R-Mutura/DISHWASHER/dish_washwer_hardware/png/Steel_form_Dish_washer 5.png

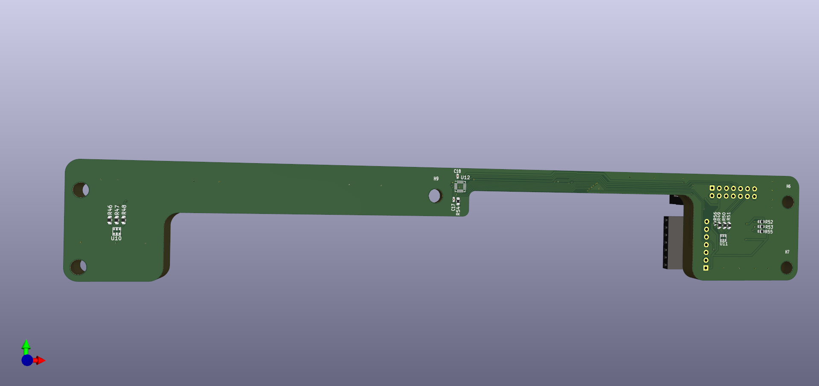
dish_washwer_hardware/png/Steel_form_Dish_washer 5.png
