R-Mutura/DISHWASHER/dish_washwer_hardware/png/Steel_form_Dish_washer 6.png

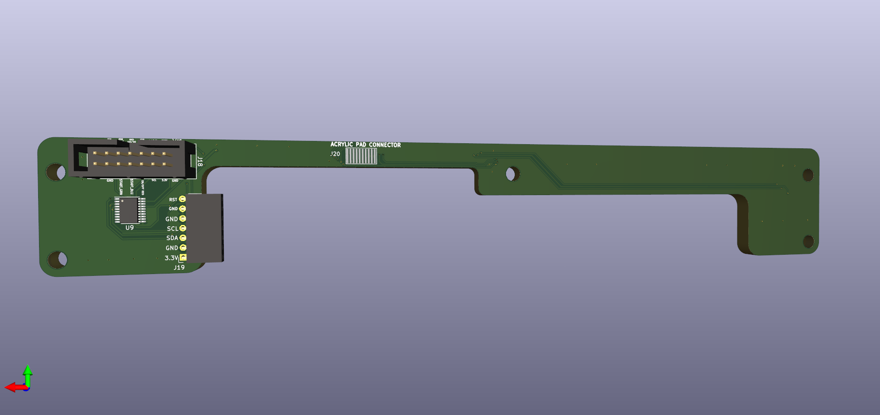
dish_washwer_hardware/png/Steel_form_Dish_washer 6.png
