R-Mutura/DISHWASHER/dish_washwer_hardware/png/main pcb 1.png

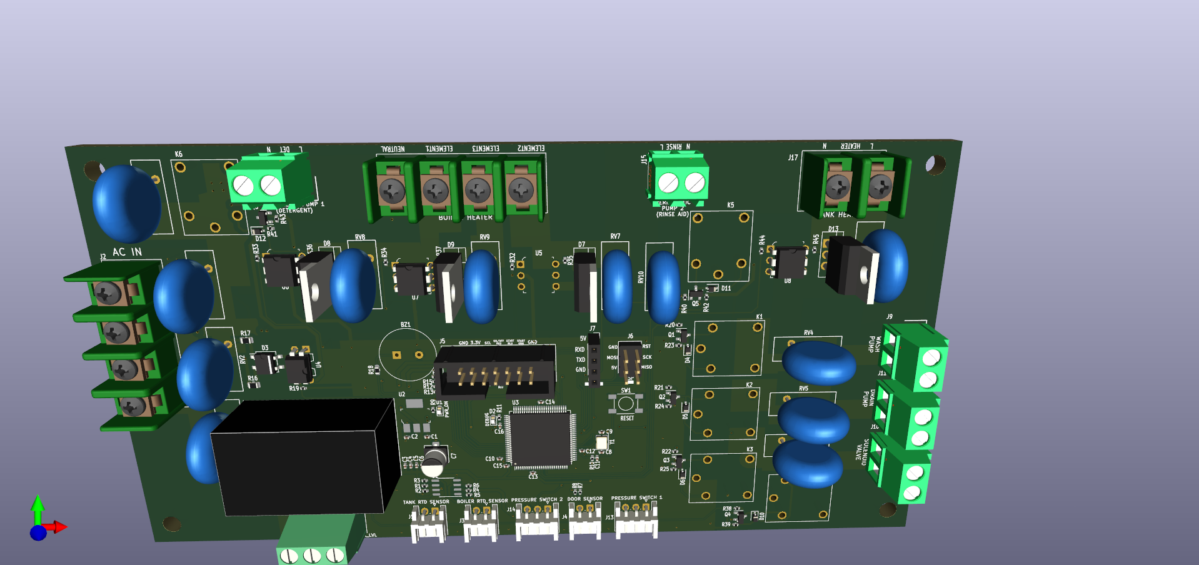
dish_washwer_hardware/png/main pcb 1.png
