R-Mutura/DISHWASHER/dish_washwer_hardware/png/main pcb 2.png

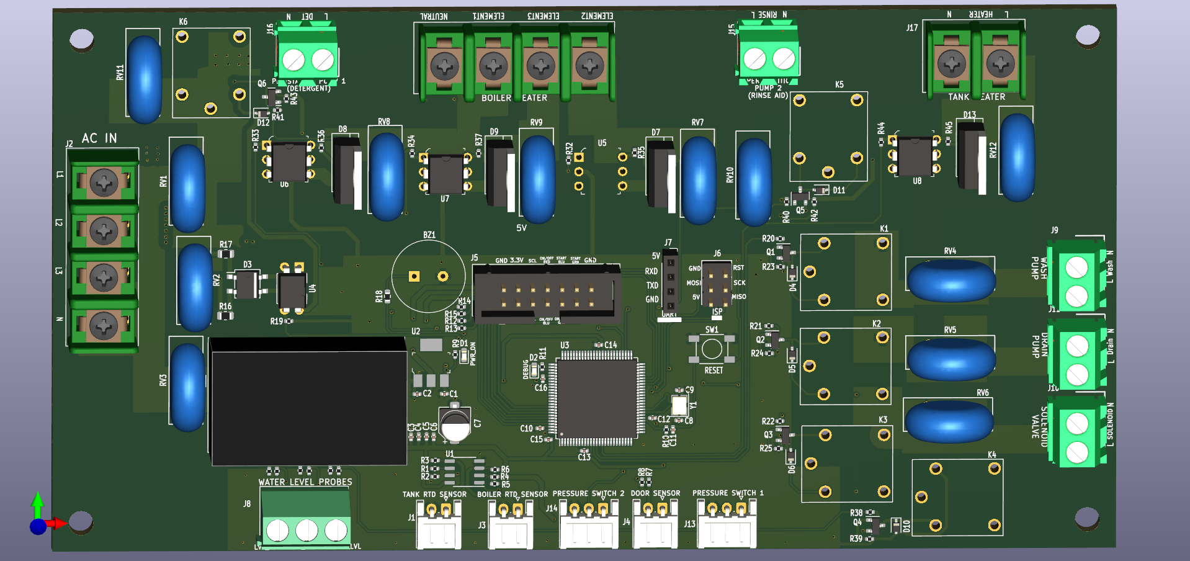
dish_washwer_hardware/png/main pcb 2.png
