R-Mutura/DISHWASHER/dish_washwer_hardware/png/main pcb 3.png

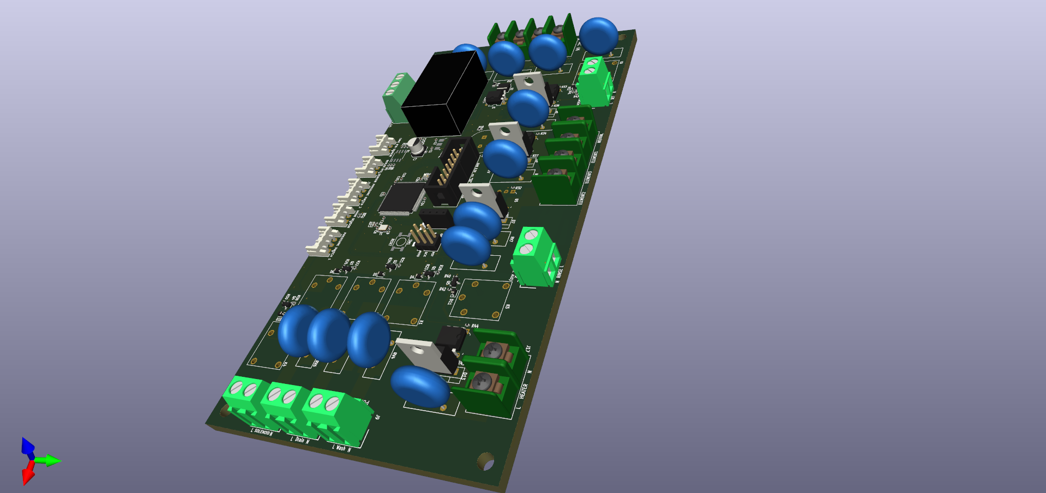
dish_washwer_hardware/png/main pcb 3.png
