R-Mutura/DISHWASHER/dish_washwer_hardware/png/Steel_form_Dish_washer 7.png

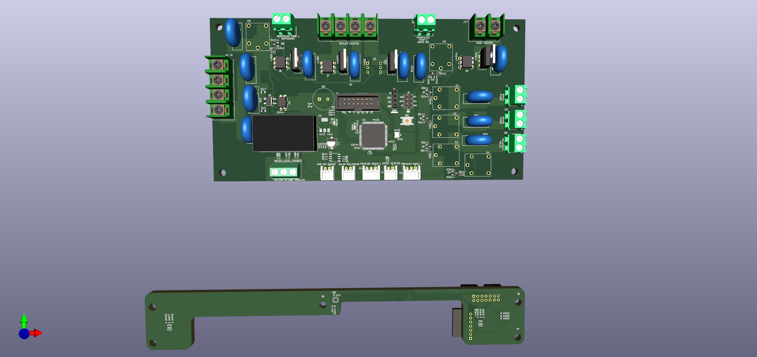
dish_washwer_hardware/png/Steel_form_Dish_washer 7.png
