R-Mutura/DISHWASHER/dish_washwer_hardware/BOM/AUXILLARY PCB BOM V2.xlsx

Reference | Value | Footprint | MPN | Vendor | QTY
C17, C18 | 100nF | Capacitor_SMD:C_0402_1005Metric | CC0402KRX5R9BB104 | LCSC | 2
J18 | Conn_02x07_Odd_Even | Connector_IDC:IDC-Header_2x07_P2.54mm_Vertical | Z-231011814106 | LCSC | 1
J19 | SCREEN CONNECTOR | Connector_PinSocket_2.54mm:PinSocket_1x07_P2.54mm_Horizontal | A2541HWR-7P | LCSC | 1
R46, R48, R49, R51 | 100R | Resistor_SMD:R_0603_1608Metric | RC0603FR-07100RL | LCSC | 4
R47, R50 | 150R | Resistor_SMD:R_0603_1608Metric | 0603WAJ0151T5E | LCSC | 2
R52, R53, R55 | 4.7K | Resistor_SMD:R_0603_1608Metric | RC0603JR-074K7L | LCSC | 3
R54 | 75K | Resistor_SMD:R_0603_1608Metric | 0603WAF7502T5E | LCSC | 1
R56 | 4.7K | Resistor_SMD:R_0402_1005Metric | RC0402FR-074K7L | LCSC | 1
U9 | TXS0108EPW | Package_SO:TSSOP-20_4.4x6.5mm_P0.65mm | TXS0108EPW | LCSC | 1
> U10, U11 | EAST1616RGBA8 | greencharge-footprints:EAST1616RGBA8 | EAST1616RGBA8 | Digikey | 2
U12 | MPR121QR2 | Package_DFN_QFN:UQFN-20_3x3mm_P0.4mm | MPR121QR2 | Digipart | 1
