R-Mutura/DISHWASHER/dish_washwer_hardware/BOM/MAIN PCB BOM V2.xlsx

Reference | Value | Footprint | MPN | Vendor | QTY
BZ1 | PS1240P02BT | digikey-footprints:Piezo_Transducer_THT_PS1240P02BT | PS1240P02BT | LCSC | 1
C1 | 10uF | Capacitor_SMD:C_0402_1005Metric | CC0402MRX5R5BB106 | LCSC | 1
C2 | 1uF | Capacitor_SMD:C_0402_1005Metric | CC0402KRX5R6BB105 | LCSC | 1
C7 | 100u | Capacitor_SMD:CP_Elec_5x5.4 | RVT100UF10V67RV0036 | LCSC | 1
C8, C9 | 22pF | Capacitor_SMD:C_0402_1005Metric | CC0402JRNPO9BN220 | LCSC | 2
C3-C6, C10, C12-C16 | 100nF | Capacitor_SMD:C_0402_1005Metric | CC0402KRX5R9BB104 | LCSC | 10
C11 | 4.7nF | Capacitor_SMD:C_0402_1005Metric | CC0402KRX7R9BB472 | LCSC | 1
D1 | LED_Small | LED_SMD:LED_0603_1608Metric | SZYY0603R | LCSC | 1
D2 | LED_Small | LED_SMD:LED_0603_1608Metric | SZYY0603B | LCSC | 1
D3 | MB6S | Package_TO_SOT_SMD:TO-269AA | MB6S | LCSC | 1
D4-D6, D10-D12 | B5819WS | Diode_SMD:D_SOD-323 | B5819WS | LCSC | 6
D7-D9, D13 | Q_TRIAC_A1A2G | Package_TO_SOT_THT:TO-220-3_Vertical | MAC223A6,126 | Digikey | 4
J1 | RTD_BOILER_SENSOR | Connector_JST:JST_EH_S2B-EH_1x02_P2.50mm_Horizontal | S2B-XH-A(LF)(SN) | LCSC | 1
J2 | AC_PWR_IN | greencharge-footprints:KF8500-4PIN | KF8500-4PIN | https://de.aliexpress.com/item/32701344105.html?gatewayAdapt=glo2deu | 1
J3 | RTD_TANK_SENSOR | Connector_JST:JST_EH_S2B-EH_1x02_P2.50mm_Horizontal | S2B-XH-A(LF)(SN) | LCSC | 1
J4 | MAG_DOOR_SENSOR | Connector_JST:JST_EH_S2B-EH_1x02_P2.50mm_Horizontal | S2B-XH-A(LF)(SN) | LCSC | 1
J5 | Conn_02x07_Odd_Even | Connector_IDC:IDC-Header_2x07_P2.54mm_Vertical | Z-231011814106 | LCSC | 1
J6 | Conn_02x03_Odd_Even | Connector_PinHeader_2.54mm:PinHeader_2x03_P2.54mm_Vertical | 210-72-03GB01 | LCSC | 1
J7 | Conn_01x04_Male | Connector_PinSocket_2.54mm:PinSocket_1x04_P2.54mm_Vertical | 210-91-04GB01 | LCSC | 1
J8 | Conn_01x03_Male | TerminalBlock_Phoenix:TerminalBlock_Phoenix_MKDS-1,5-3-5.08_1x03_P5.08mm_Horizontal | WJ500V-5.08-3P | LCSC | 1
J9 | WASH PUMP CONNECTOR | greencharge-footprints:SHDR2W100P0X508_1X2_1070X900X1380P | DB128V-5.0-4P-GN-S | LCSC | 1
J10 | SOLENOID CONNECTOR | greencharge-footprints:SHDR2W100P0X508_1X2_1070X900X1380P | XY126V-5.0-2P | LCSC | 1
J11 | DRAIN PUMP CONNECTOR | greencharge-footprints:SHDR2W100P0X508_1X2_1070X900X1380P | XY126V-5.0-2P | LCSC | 1
J12 | BOILER HEATER CONNECTOR | greencharge-footprints:KF8500-4PIN | KF8500-4PIN | https://de.aliexpress.com/item/32701344105.html?gatewayAdapt=glo2deu | 1
J13 | Pressure Switch 1 | Connector_JST:JST_EH_S3B-EH_1x03_P2.50mm_Horizontal | S3B-XH-A(LF)(SN) | LCSC | 1
J14 | Pressure Switch 2 | Connector_JST:JST_EH_S3B-EH_1x03_P2.50mm_Horizontal | S3B-XH-A(LF)(SN) | LCSC | 1
J15 | peristaltic_pump_1 | greencharge-footprints:SHDR2W100P0X508_1X2_1070X900X1380P | XY126V-5.0-2P | LCSC | 1
J16 | peristaltic_pump_2 | greencharge-footprints:SHDR2W100P0X508_1X2_1070X900X1380P | XY126V-5.0-2P | LCSC | 1
J17 | TANK HEATER | greencharge-footprints:KF8500-2PIN | KF8500-2PIN | https://de.aliexpress.com/item/32701344105.html?gatewayAdapt=glo2deu | 1
K1-K6 | SRA-05VDC-CL | greencharge-footprints:SRA-05VDC-CL | SRA-05VDC-CL | LCSC | 6
PS1 | HLK-PM01 | Converter_ACDC:Converter_ACDC_HiLink_HLK-PMxx | HLK-PM01 | LCSC | 1
Q1-Q3, Q5, Q6 | mmbt3904 | Package_TO_SOT_SMD:SOT-23 | mmbt3904 | LCSC | 5
Q4 | AP2301 | Package_TO_SOT_SMD:SOT-23 | AP2301 | LCSC | 1
R2, R5, R19, R26-R28, R38 | 1K | Resistor_SMD:R_0402_1005Metric | RC0402FR-071KL | LCSC | 7
R7, R32-R34, R44 | 200R | Resistor_SMD:R_0402_1005Metric | RC0402FR-07200RL | LCSC | 5
R9, R11 | 500R | Resistor_SMD:R_0402_1005Metric | RC0402FR-07523RL | LCSC | 2
R1, R3, R4, R6, R8, R10, R23-R25, R35-R37, R39, R42, R43, R45 | 10K | Resistor_SMD:R_0402_1005Metric | AC0402FR-0710KL | LCSC | 16
R12-R15 | 4.7k | Resistor_SMD:R_0402_1005Metric | RC0402FR-074K7L | LCSC | 4
R16, R17 | 47K | Resistor_SMD:R_0805_2012Metric | RC0402FR-0747KL | LCSC | 2
R18 | 100R | Resistor_SMD:R_0603_1608Metric | RC0402FR-07100RL | LCSC | 1
R20-R22, R40, R41 | (680R) | Resistor_SMD:R_0402_1005Metric | 0402WGF6800TCE | LCSC | 5
R29-R31 | 1M | Resistor_SMD:R_0402_1005Metric | AC0402FR-071ML | LCSC | 3
RV1-RV6, RV10-RV12 | CNR-10D511KBTSA | Varistor:RV_Disc_D15.5mm_W5.9mm_P7.5mm | CNR-10D511KBTSA | LCSC | 9
RV7-RV9 | CNR-10D511KBTSA | Varistor:RV_Disc_D15.5mm_W5.9mm_P7.5mm | CNR-10D511KBTSA | LCSC | 3
SW1 | SW_Push | greencharge-footprints:K2-1187SQ-D4SW-06 | K2-1187SQ-D4SW-06 | LCSC | 1
U1 | LM358 | Package_SO:SO-8_3.9x4.9mm_P1.27mm | LM358DG | Digikey | 1
U2 | AMS1117-3.3 | digikey-footprints:SOT-223 | AMS1117-3.3 | LCSC | 1
U3 | ATmega2560-16AU | Package_QFP:TQFP-100_14x14mm_P0.5mm | ATmega2560-16AU | https://www.alibaba.com/product-detail/atmega2560-16au-8-bit-Microcontroller-atmega2560_60754702711.html | 1
U4 | EL817 | Package_DIP:DIP-4_W7.62mm | EL817S1(B)(TU)-F | LCSC | 1
U5-U8 | MOC3021 | digikey-footprints:DIP-6_W7.62mm | MOC3021M | LCSC | 4
Y1 | 16MHz | Crystal:Crystal_SMD_SeikoEpson_FA238-4Pin_3.2x2.5mm | S3216000091060 | LCSC | 1
