R-Mutura/DISHWASHER/dish_washwer_hardware/BOM/dish washer BOM repair.xls

PCBWay Bom Quotation, Product No.:T-1Y10W491754A
Item # | *Designator | *Qty | *Mfg Part # | Description / Value | *Package/Footprint | *Unit Price(5 sets) | *Total | *Delivery Time | *Actual Purchase Mfg Part # | *PCBWay Note | replacement | Price
1 | BZ1 | 1 | PS1240P02BT | PS1240P02BT | digikey-footprints:Piezo_Transducer_THT_PS1240P02BT | $0.267 | $1.335
2 | C3 | 1 | CC0402MRX5R5BB106 | 10uF | Capacitor_SMD:C_0402_1005Metric | $0.124 | $0.620
3 | C4 | 1 | CC0402KRX5R6BB105 | 1uF | Capacitor_SMD:C_0402_1005Metric | $0.065 | $0.325
4 | C13 | 1 | RVT100UF10V67RV0036 | 100u | Capacitor_SMD:CP_Elec_5x5.4 | $0.180 | $0.900
5 | C14,C15 | 2 | CC0402JRNPO9BN220 | 22pF | Capacitor_SMD:C_0402_1005Metric | $0.014 | $0.140
6 | C17 | 1 | CC0402KRX7R9BB472 | 4.7nF | Capacitor_SMD:C_0402_1005Metric | $0.030 | $0.150
7 | C1,C2,C5-C12,C16,C18-C24 | 18 | CC0402KRX5R9BB104 | 100nF | Capacitor_SMD:C_0402_1005Metric | $0.027 | $2.430
8 | D1 | 1 | SZYY0603R | LED_Small | LED_SMD:LED_0603_1608Metric | $0.113 | $0.565
9 | D2 | 1 | SZYY0603B | LED_Small | LED_SMD:LED_0603_1608Metric | $0.146 | $0.730
10 | D3 | 1 | MB6S | MB6S | Package_TO_SOT_SMD:TO-269AA | $0.596 | $2.980 | 7-10 Workdays
11 | D4-D6,D9 | 4 | BTA30-600CW3G | Q_TRIAC_A1A2G | Package_TO_SOT_THT:TO-220-3_Vertical | $3.560 | $71.200 |  |  |  | MAC223A6,127 | 1.89
12 | J1 | 1 | S03B-XASS-1N-BN(LF)(SN) | RTD_TANK_SENSOR | Connector_JST:JST_EH_S3B-EH_1x03_P2.50mm_Horizontal | $0.381 | $1.905
13 | J2 | 1 | S03B-XASS-1N-BN(LF)(SN) | RTD_BOILER_SENSOR | Connector_JST:JST_EH_S3B-EH_1x03_P2.50mm_Horizontal | $0.381 | $1.905
14 | J3 | 1 | 387207505 | AC_PWR_IN | greencharge-footprints:387207505 | $5.092 | $25.460 | 7-10 Workdays | 38720-7505 |  | KF8500-2/3/4Pin | 1.98/5pieces
15 | J4 | 1 | S02B-XASS-1N-BN(LF)(SN) | MAG_DOOR_SENSOR | Connector_JST:JST_EH_S2B-EH_1x02_P2.50mm_Horizontal | $0.407 | $2.035
16 | J5,J18 | 2 | Z-231011814106 | Conn_02x07_Odd_Even | Connector_IDC:IDC-Header_2x07_P2.54mm_Vertical | $0.263 | $2.630
17 | J6 | 1 | 210-72-03GB01 | Conn_02x03_Odd_Even | Connector_PinHeader_2.54mm:PinHeader_2x03_P2.54mm_Vertical | $0.202 | $1.010
18 | J7 | 1 | 210-91-04GB01 | Conn_01x04_Male | Connector_PinSocket_2.54mm:PinSocket_1x04_P2.54mm_Vertical | $0.170 | $0.850
19 | J8 | 1 | DB128V-5.0-4P-GN-S | Water sensor connector | TerminalBlock_Phoenix:TerminalBlock_Phoenix_MKDS-1,5-4_1x04_P5.00mm_Horizontal | $0.421 | $2.105
20 | J9 | 1 | DB128V-5.0-4P-GN-S | WASH PUMP CONNECTOR | greencharge-footprints:SHDR2W100P0X508_1X2_1070X900X1380P | $0.421 | $2.105
21 | J10 | 1 | XY126V-5.0-2P | SOLENOID CONNECTOR | greencharge-footprints:SHDR2W100P0X508_1X2_1070X900X1380P | $0.196 | $0.980
22 | J11 | 1 | XY126V-5.0-2P | DRAIN PUMP CONNECTOR | greencharge-footprints:SHDR2W100P0X508_1X2_1070X900X1380P | $0.196 | $0.980
23 | J12 | 1 | 6PCV_04_006 | BOILER HEATER CONNECTOR | greencharge-footprints:barrier_terminal_6PCV_04_006 | $2.928 | $14.640 |  | 6PCV-04-006 |  | KF8500-2/3/4Pin | 1.98/5pieces
24 | J13 | 1 | S3B-XH-A(LF)(SN) | Pressure Switch 1 | Connector_JST:JST_EH_S3B-EH_1x03_P2.50mm_Horizontal | $0.407 | $2.035
25 | J14 | 1 | S3B-XH-A(LF)(SN) | Pressure Switch 2 | Connector_JST:JST_EH_S3B-EH_1x03_P2.50mm_Horizontal | $0.407 | $2.035
26 | J15 | 1 | XY126V-5.0-2P | peristaltic_pump_2 | greencharge-footprints:SHDR2W100P0X508_1X2_1070X900X1380P | $0.196 | $0.980
27 | J16 | 1 | XY126V-5.0-2P | peristaltic_pump_1 | greencharge-footprints:SHDR2W100P0X508_1X2_1070X900X1380P | $0.196 | $0.980
28 | J17 | 1 | 6PCV02006 | TANK HEATER | greencharge-footprints:6PCV02006 | $2.456 | $12.280 | 7-10 Workdays | 6PCV-02-006 |  | KF8500-2/3/4Pin | 1.48/5pieces
29 | J19 | 1 | A2541HWR-7P | SCREEN CONNECTOR | Connector_PinSocket_2.54mm:PinSocket_1x07_P2.54mm_Horizontal | $0.274 | $1.370
30 | K1-K6 | 6 | 9-1440003-0 | 9-1440003-0 | greencharge-footprints:TE_9-1440003-0 | $1.390 | $41.700 | 15 Workdays |  |  | SRA-05VDC-CL | 0.52
31 | PS1 | 1 | HLK-5M05 | HLK-5M05 | greencharge-footprints:CONV_HLK-5M05 | $4.272 | $21.360 |  |  |  | HLK-PM01
32 | Q4 | 1 | DMP6250SE-13 | DMP6023L3-13 | Package_TO_SOT_SMD:SOT-223-3_TabPin2 | $0.918 | $4.590 |  |  |  | AP2301 | 0.029
33 | Q1-Q3,Q5,Q6 | 5 | WST2N7002K | WST2N7002K | Package_TO_SOT_SMD:SOT-23 | $0.078 | $1.950 |  |  |  | mmbt3905 | 0.0119
34 | R1,R2 | 2 | AC0402FR-074K3L | 4300 R_0.1% | Resistor_SMD:R_0402_1005Metric | $0.012 | $0.120
35 | R3,R21-R23,R31 | 5 | RC0402FR-07200RL | 200R | Resistor_SMD:R_0402_1005Metric | $0.004 | $0.100
36 | R4,R6 | 2 | RC0402FR-07523RL | 500R | Resistor_SMD:R_0402_1005Metric | $0.008 | $0.080
37 | R7-R10 | 4 | RC0402FR-074K7L | 4.7k | Resistor_SMD:R_0402_1005Metric | $0.004 | $0.080
38 | R11,R12 | 2 | RC0402FR-0747KL | 47K | Resistor_SMD:R_0805_2012Metric | $0.037 | $0.370
39 | R13,R35,R37,R38,R40 | 5 | RC0402FR-07100RL | 100R | Resistor_SMD:R_0603_1608Metric | $0.003 | $0.075
40 | R14-R17,R27,R30,R32,R33,R48,R49 | 10 | RC0402FR-071KL | 1K | Resistor_SMD:R_0402_1005Metric | $0.002 | $0.100
41 | R5,R18-R20,R24-R26,R28,R29,R34,R50,R51 | 12 | AC0402FR-0710KL | 10K | Resistor_SMD:R_0402_1005Metric | $0.002 | $0.120
42 | R36,R39 | 2 | 0603WAJ0151T5E | 150R | Resistor_SMD:R_0603_1608Metric | $0.014 | $0.140
43 | R41,R42,R44 | 3 | RC0603JR-074K7L | 4.7K | Resistor_SMD:R_0603_1608Metric | $0.008 | $0.120
44 | R43 | 1 | 0603WAF7502T5E | 75K | Resistor_SMD:R_0603_1608Metric | $0.033 | $0.165
45 | R45-R47 | 3 | AC0402FR-071ML | 1M | Resistor_SMD:R_0402_1005Metric | $0.007 | $0.105
46 | R52 | 1 | RC0402FR-074K7L | 4.7K | Resistor_SMD:R_0402_1005Metric | $0.015 | $0.075
47 | RV1-RV12 | 12 | VDR-14D181K | VDR-14D181K | Varistor:RV_Disc_D16.5mm_W6.7mm_P7.5mm | $0.119 | $7.140 |  |  |  | CNR-10D511KBTSA | 0.0888
48 | SW1 | 1 | K2-1187SQ-D4SW-06 | SW_Push | greencharge-footprints:K2-1187SQ-D4SW-06 | $0.199 | $0.995
49 | U1,U2 | 2 | MAX31865ATP+T | MAX31865ATP+T | greencharge-footprints:QFN65P500X500X80-21N | $35.794 | $357.940 |  |  |  | LM358DT | 0.0536
50 | U3 | 1 | LM1117-3.3 | LM1117-3.3 | digikey-footprints:SOT-223 | $2.506 | $12.530 | 7-10 Workdays | LM1117T-3.3/NOPB |  | C369933 | 0.1006
51 | U4 | 1 | ATmega2560-16AU | ATmega2560-16AU | Package_QFP:TQFP-100_14x14mm_P0.5mm | $48.500 | $242.500
52 | U5 | 1 | EL817 | EL817 | Package_DIP:DIP-4_W7.62mm | $0.678 | $3.390 |  | EL817S1(C)(TU)-F
53 | U6-U8,U11 | 4 | MOC3021 | MOC3021 | digikey-footprints:DIP-6_W7.62mm | $0.242 | $4.840
54 | U12 | 1 | TXS0108EPW | TXS0108EPW | Package_SO:TSSOP-20_4.4x6.5mm_P0.65mm | $1.085 | $5.425 |  | TXS0108EPWR
55 | U13,U14 | 2 | EAST1616RGBA8 | EAST1616RGBA8 | greencharge-footprints:EAST1616RGBA8 | $0.404 | $4.040 | 7-10 Workdays
56 | U15 | 1 | MPR121QR2 | MPR121QR2 | Package_DFN_QFN:UQFN-20_3x3mm_P0.4mm | $2.136 | $10.680
57 | Y1 | 1 | C3E-16.000-12-1010-M | C3E-16.000-12-1010-M | Crystal:Crystal_SMD_SeikoEpson_FA238-4Pin_3.2x2.5mm |  |  |  |  | It's out of stock. Please recommend substitutes or you can supply this part to us. | S3216000091060 | 0.1084
 |  |  |  |  |  | All Total | $878.390
