R-Mutura/DISHWASHER/dish_washwer_hardware/sch_pdf/dishwasher schematics.pdf

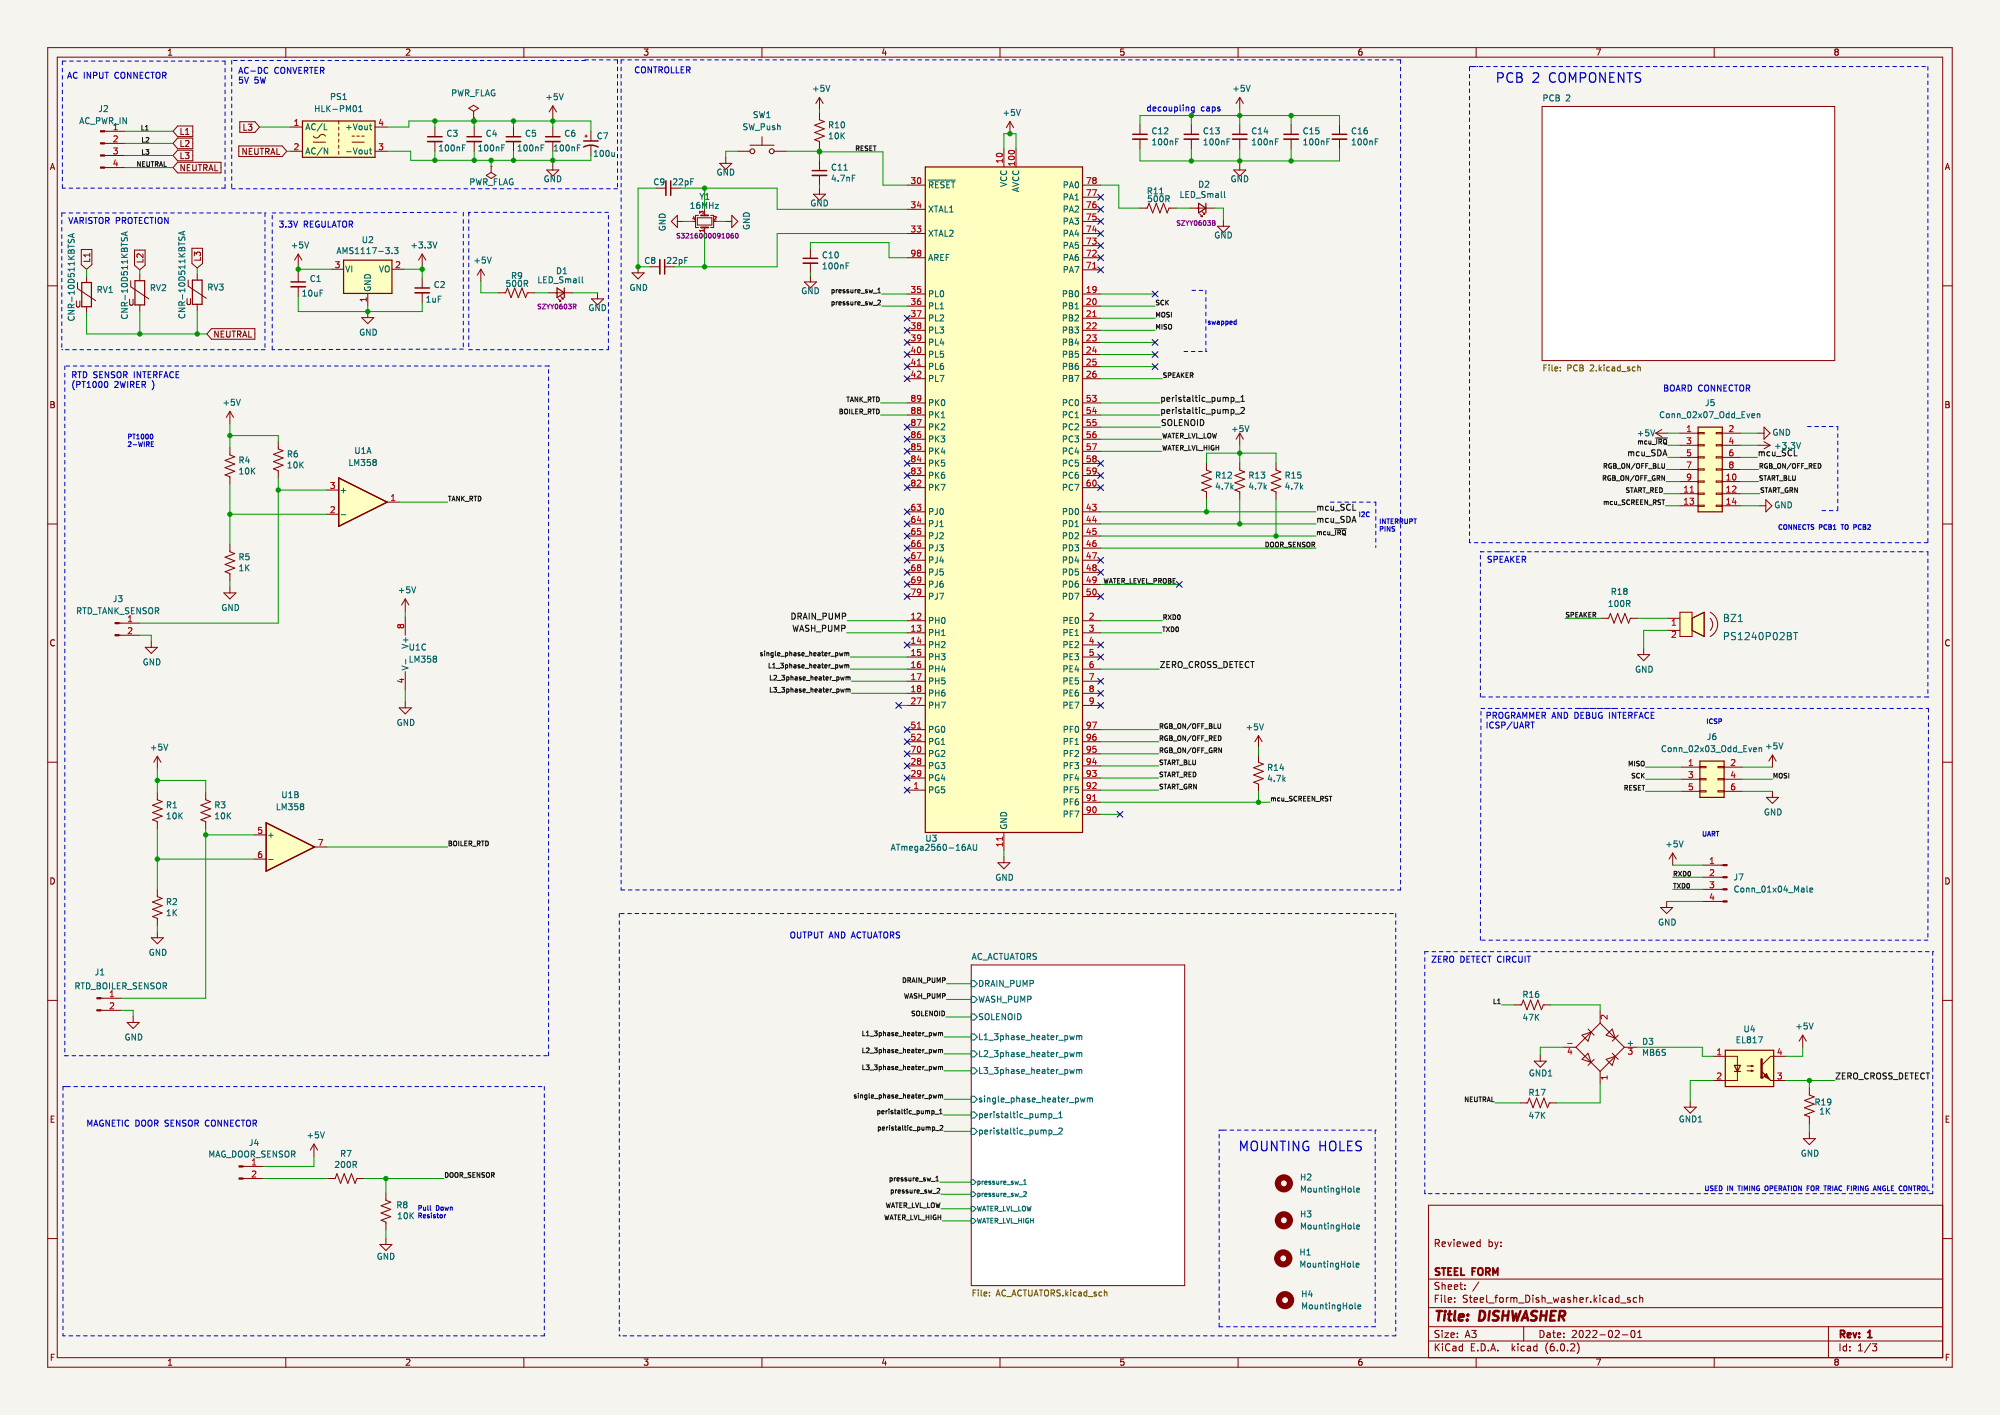
[picture p8: page 1]

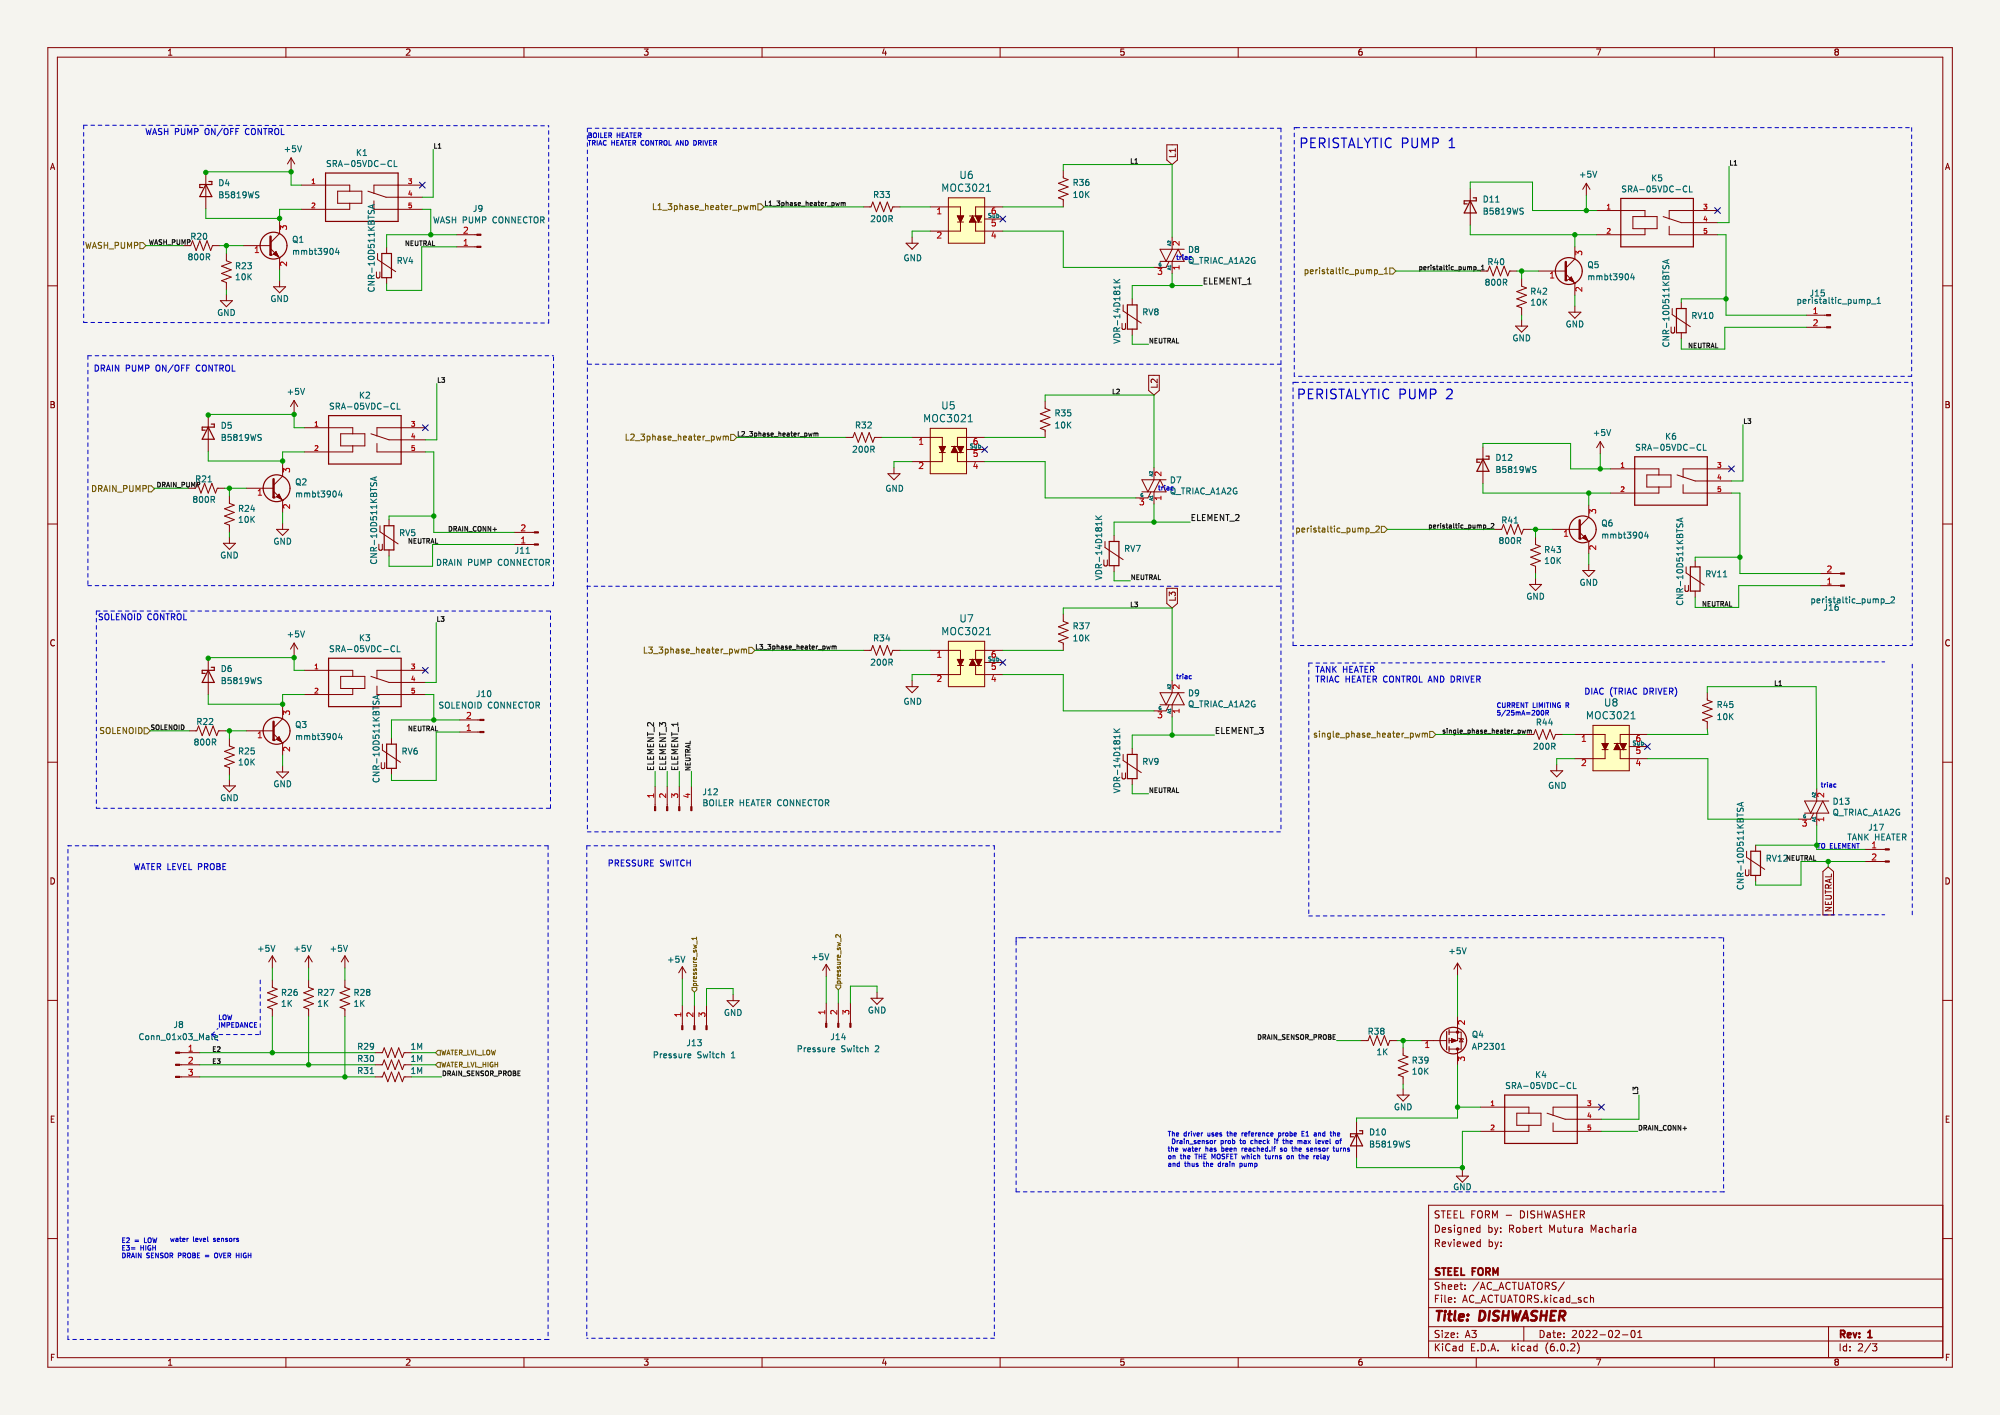
[picture p9: page 2]

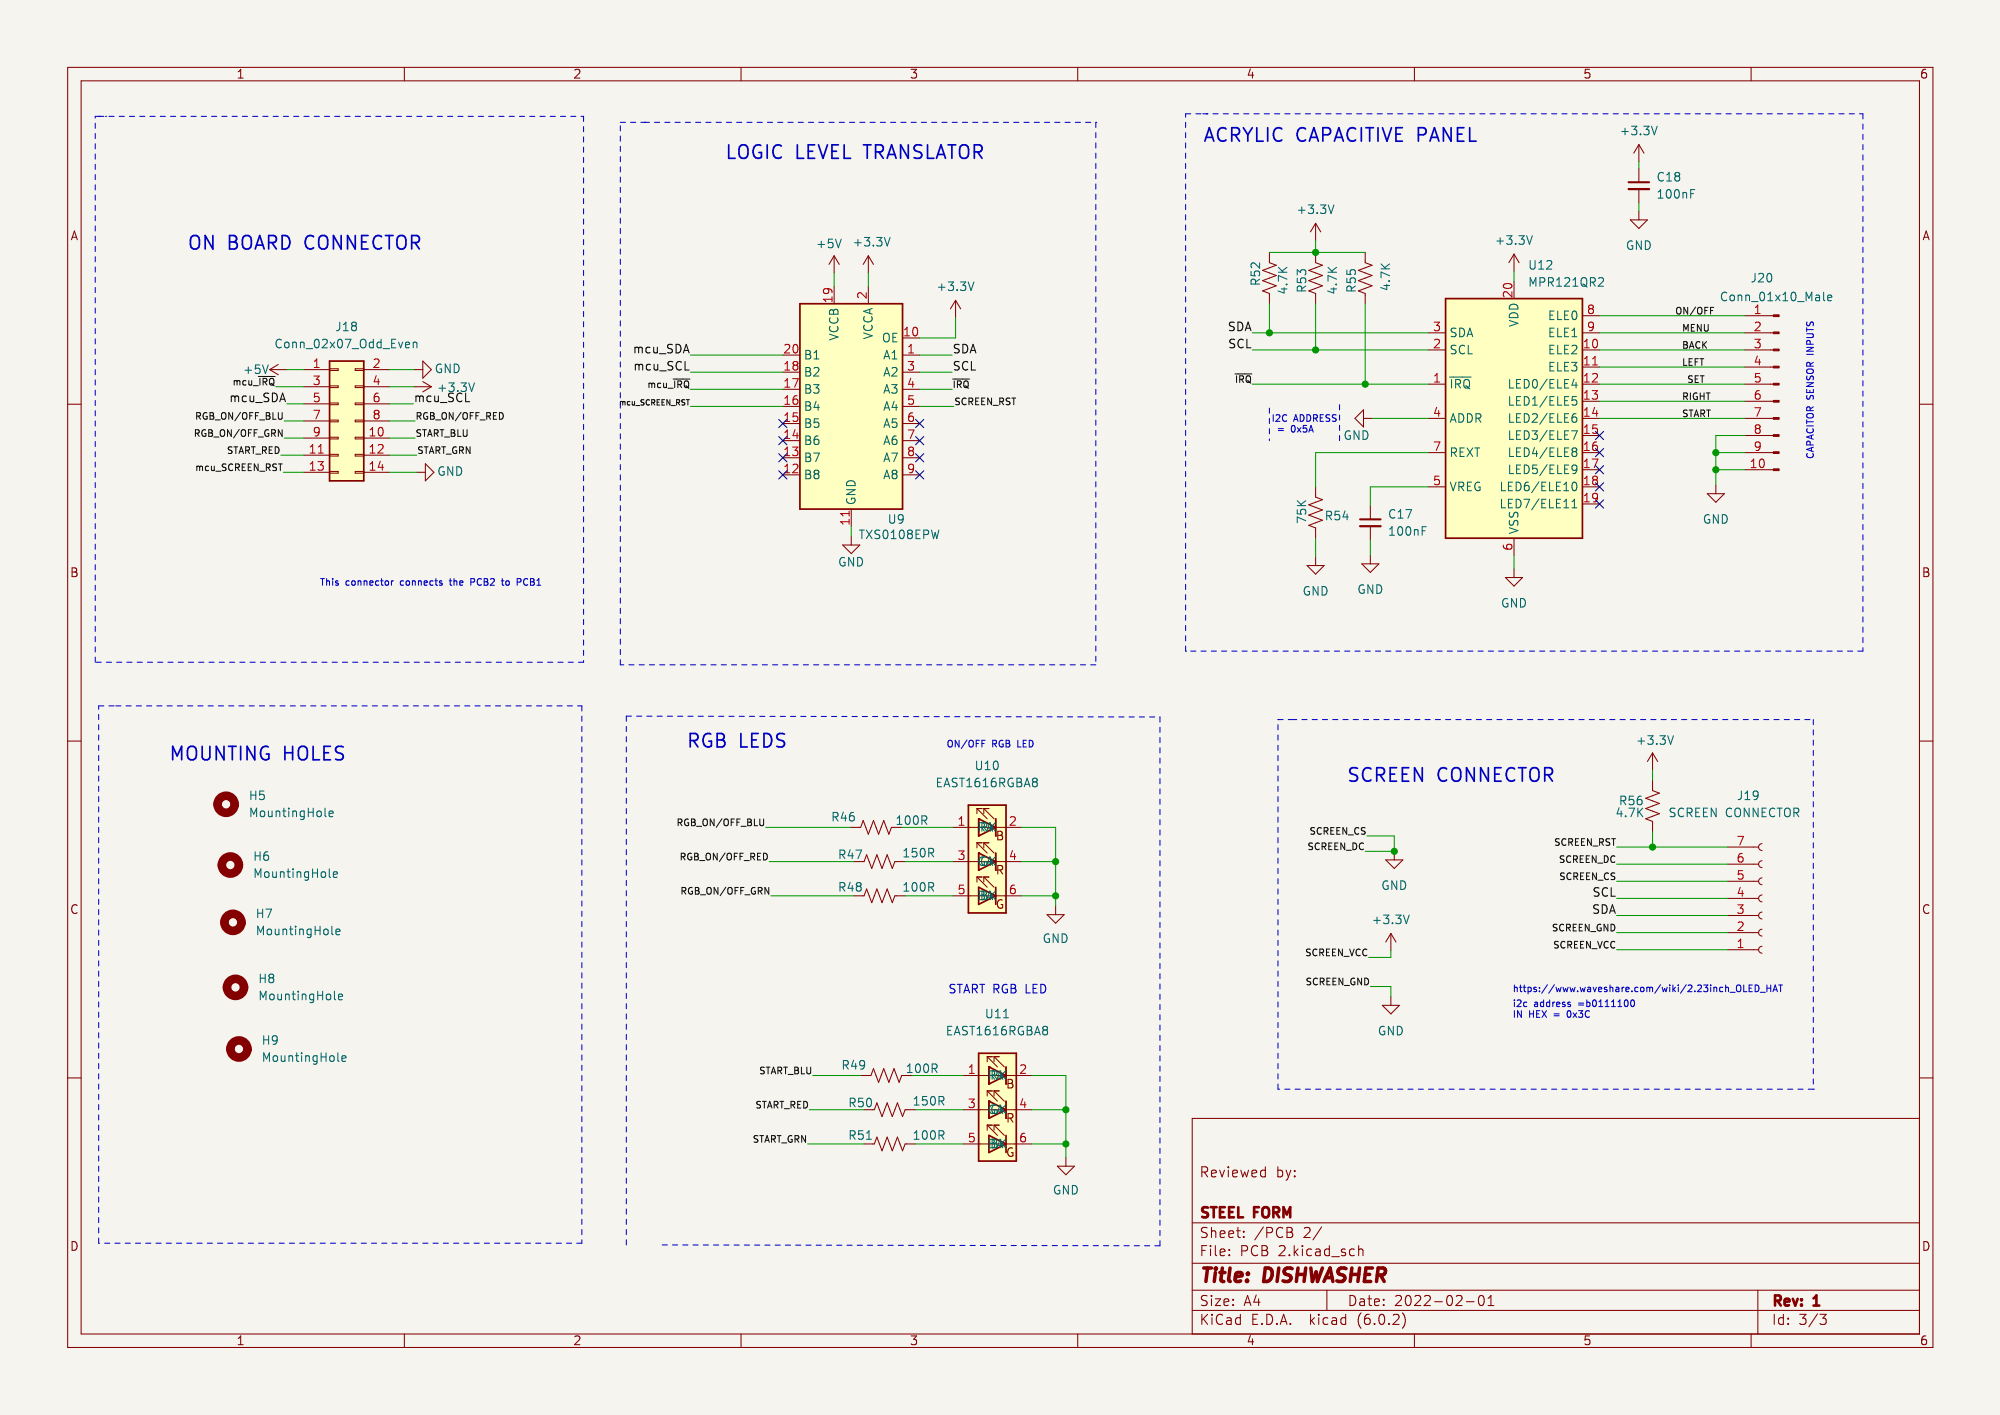
[picture p10: page 3]
