R-Mutura/DISHWASHER/(commit log)

2022-01-08 update schematic zero detect circuit
    [Steel_form_Dish_washer.sch]
2022-01-08 footprint assignment and Varistor
    [AC_ACTUATORS.sch, Steel_form_Dish_washer.sch]
2022-01-28 updated dishwasher schematic
    [AC_ACTUATORS.kicad_sch, OLED SCREEN.kicad_sch, Steel_form_Dish_washer.kicad_sch, Steel_form_Dish_washer.sch]
2022-01-31 complete schematic and assignment
    [AC_ACTUATORS.kicad_sch, PCB 2.kicad_sch, Steel_form_Dish_washer.kicad_pcb, Steel_form_Dish_washer.kicad_sch]
2022-02-01 layout start
    [Steel_form_Dish_washer.kicad_pcb]
2022-02-01 updated layout high voltage
    [AC_ACTUATORS.kicad_sch, Steel_form_Dish_washer.kicad_pcb, Steel_form_Dish_washer.kicad_sch]
2022-02-01 updating layout
    [AC_ACTUATORS.kicad_sch, Steel_form_Dish_washer.kicad_pcb]
2022-02-01 on going
    [Steel_form_Dish_washer.kicad_pcb]
2022-02-01 updated layout
    [AC_ACTUATORS.kicad_sch, Steel_form_Dish_washer.kicad_sch]
2022-02-01 layout placement complete
    [AC_ACTUATORS.kicad_sch, Steel_form_Dish_washer.kicad_pcb]
2022-02-01 updating layout and routing
    [Steel_form_Dish_washer.kicad_pcb, Steel_form_Dish_washer.kicad_sch]
2022-02-01 board connector update(14)
    [PCB 2.kicad_sch, Steel_form_Dish_washer.kicad_pcb, Steel_form_Dish_washer.kicad_sch]
2022-02-01 layout at 90%
    [Steel_form_Dish_washer.kicad_pcb]
2022-02-01 layout complete
    [Steel_form_Dish_washer.kicad_pcb, Steel_form_Dish_washer.kicad_sch]
2022-02-01 updated production files
    [Steel_form_Dish_washer-B_Cu.gbr, Steel_form_Dish_washer-B_Mask.gbr, Steel_form_Dish_washer-B_Paste.gbr, Steel_form_Dish_washer-B_Silkscreen.gbr, Steel_form_Dish_washer-Edge_Cuts.gbr, Steel_form_Dish_washer-F_Cu.gbr, Steel_form_Dish_washer-F_Mask.gbr, Steel_form_Dish_washer-F_Paste.gbr]
2022-02-01 updated level connector
    [AC_ACTUATORS.kicad_sch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]
2022-02-01 updated BOM
    [Steel_form_Dish_washer.xlsx]
2022-02-02 Resolved error on ICSP pins
    [AC_ACTUATORS.kicad_sch, PCB 2.kicad_sch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]
2022-02-04 updated water level sensor
    [AC_ACTUATORS.kicad_sch, PCB 2.kicad_sch, Steel_form_Dish_washer.kicad_pcb, Steel_form_Dish_washer.kicad_sch]
2022-02-05 updated dishwasher layout
    [PCB 2.kicad_sch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]
2022-02-07 updated pullup+debug
    [PCB 2.kicad_sch, Steel_form_Dish_washer.kicad_pcb, Steel_form_Dish_washer.kicad_sch]
2022-02-07 updated pullup+debug+water sensor
2022-02-10 updated firmware
    [AC_ACTUATORS.kicad_sch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]
2022-02-11 commissionin process + isr added
    [PCB 2.kicad_sch, Steel_form_Dish_washer.kicad_sch]
2022-02-11 HEATER pid control functions
2022-02-12 timing interrupt + pid
    [AC_ACTUATORS.kicad_sch, PCB 2.kicad_sch, Steel_form_Dish_washer.kicad_pcb, Steel_form_Dish_washer.kicad_sch]
2022-02-22 major change in hardware layout Firmware 85% complete
    [12V_TO_5V BUCK.sch, AC_ACTUATORS.kicad_sch, AC_ACTUATORS.sch, AC_DC_step_DOWN(240V-12V).sch, DISHWASHER BOM.xlsx, OLED SCREEN.kicad_sch, PCB 2.kicad_sch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]
2022-02-22 commit hardware major update firmware 85%
    [Steel_form_Dish_washer PART 1-B_Cu.gbr, Steel_form_Dish_washer PART 1-B_Mask.gbr, Steel_form_Dish_washer PART 1-B_Paste.gbr, Steel_form_Dish_washer PART 1-B_Silkscreen.gbr, Steel_form_Dish_washer PART 1-Edge_Cuts.gbr, Steel_form_Dish_washer PART 1-F_Cu.gbr, Steel_form_Dish_washer PART 1-F_Mask.gbr, Steel_form_Dish_washer PART 1-F_Paste.gbr]
2022-03-01 cheaper version layout
    [AC_ACTUATORS.kicad_sch, AUXILLARY PCB BOM.xlsx, DISHWASHER BOM.xlsx, MAIN PCB BOM.xlsx, PCB 2.kicad_sch, Steel_form_Dish_washer.kicad_pcb, Steel_form_Dish_washer.kicad_sch, Steel_form_Dish_washer.xlsx]
2022-03-01 scare 1
    [AC_ACTUATORS.kicad_sch, Steel_form_Dish_washer.kicad_pcb, Steel_form_Dish_washer.kicad_sch]
2022-03-01 main pcb layout complete
    [Steel_form_Dish_washer.kicad_pcb]
2022-03-02 complete layout and schematic
    [Steel_form_Dish_washer PART 1-B_Cu.gbr, Steel_form_Dish_washer PART 1-B_Mask.gbr, Steel_form_Dish_washer PART 1-B_Paste.gbr, Steel_form_Dish_washer PART 1-B_Silkscreen.gbr, Steel_form_Dish_washer PART 1-Edge_Cuts.gbr, Steel_form_Dish_washer PART 1-F_Cu.gbr, Steel_form_Dish_washer PART 1-F_Mask.gbr, Steel_form_Dish_washer PART 1-F_Paste.gbr]
2022-03-02 layput update
    [AUXILLARY PCB BOM V2.xlsx, MAIN PCB BOM V2.xlsx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]
2022-03-10 updated firmware rinse aid startup doseage
    [12V_TO_5V BUCK.sch, AC_ACTUATORS.kicad_sch, AC_ACTUATORS.sch, AC_DC_step_DOWN(240V-12V).sch, OLED SCREEN.kicad_sch, PCB 2.kicad_sch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]
